trnila/homjachit/board/hamboard.kicad_pcb

## KiCad design board/hamboard.kicad_pcb (2022-09-10)

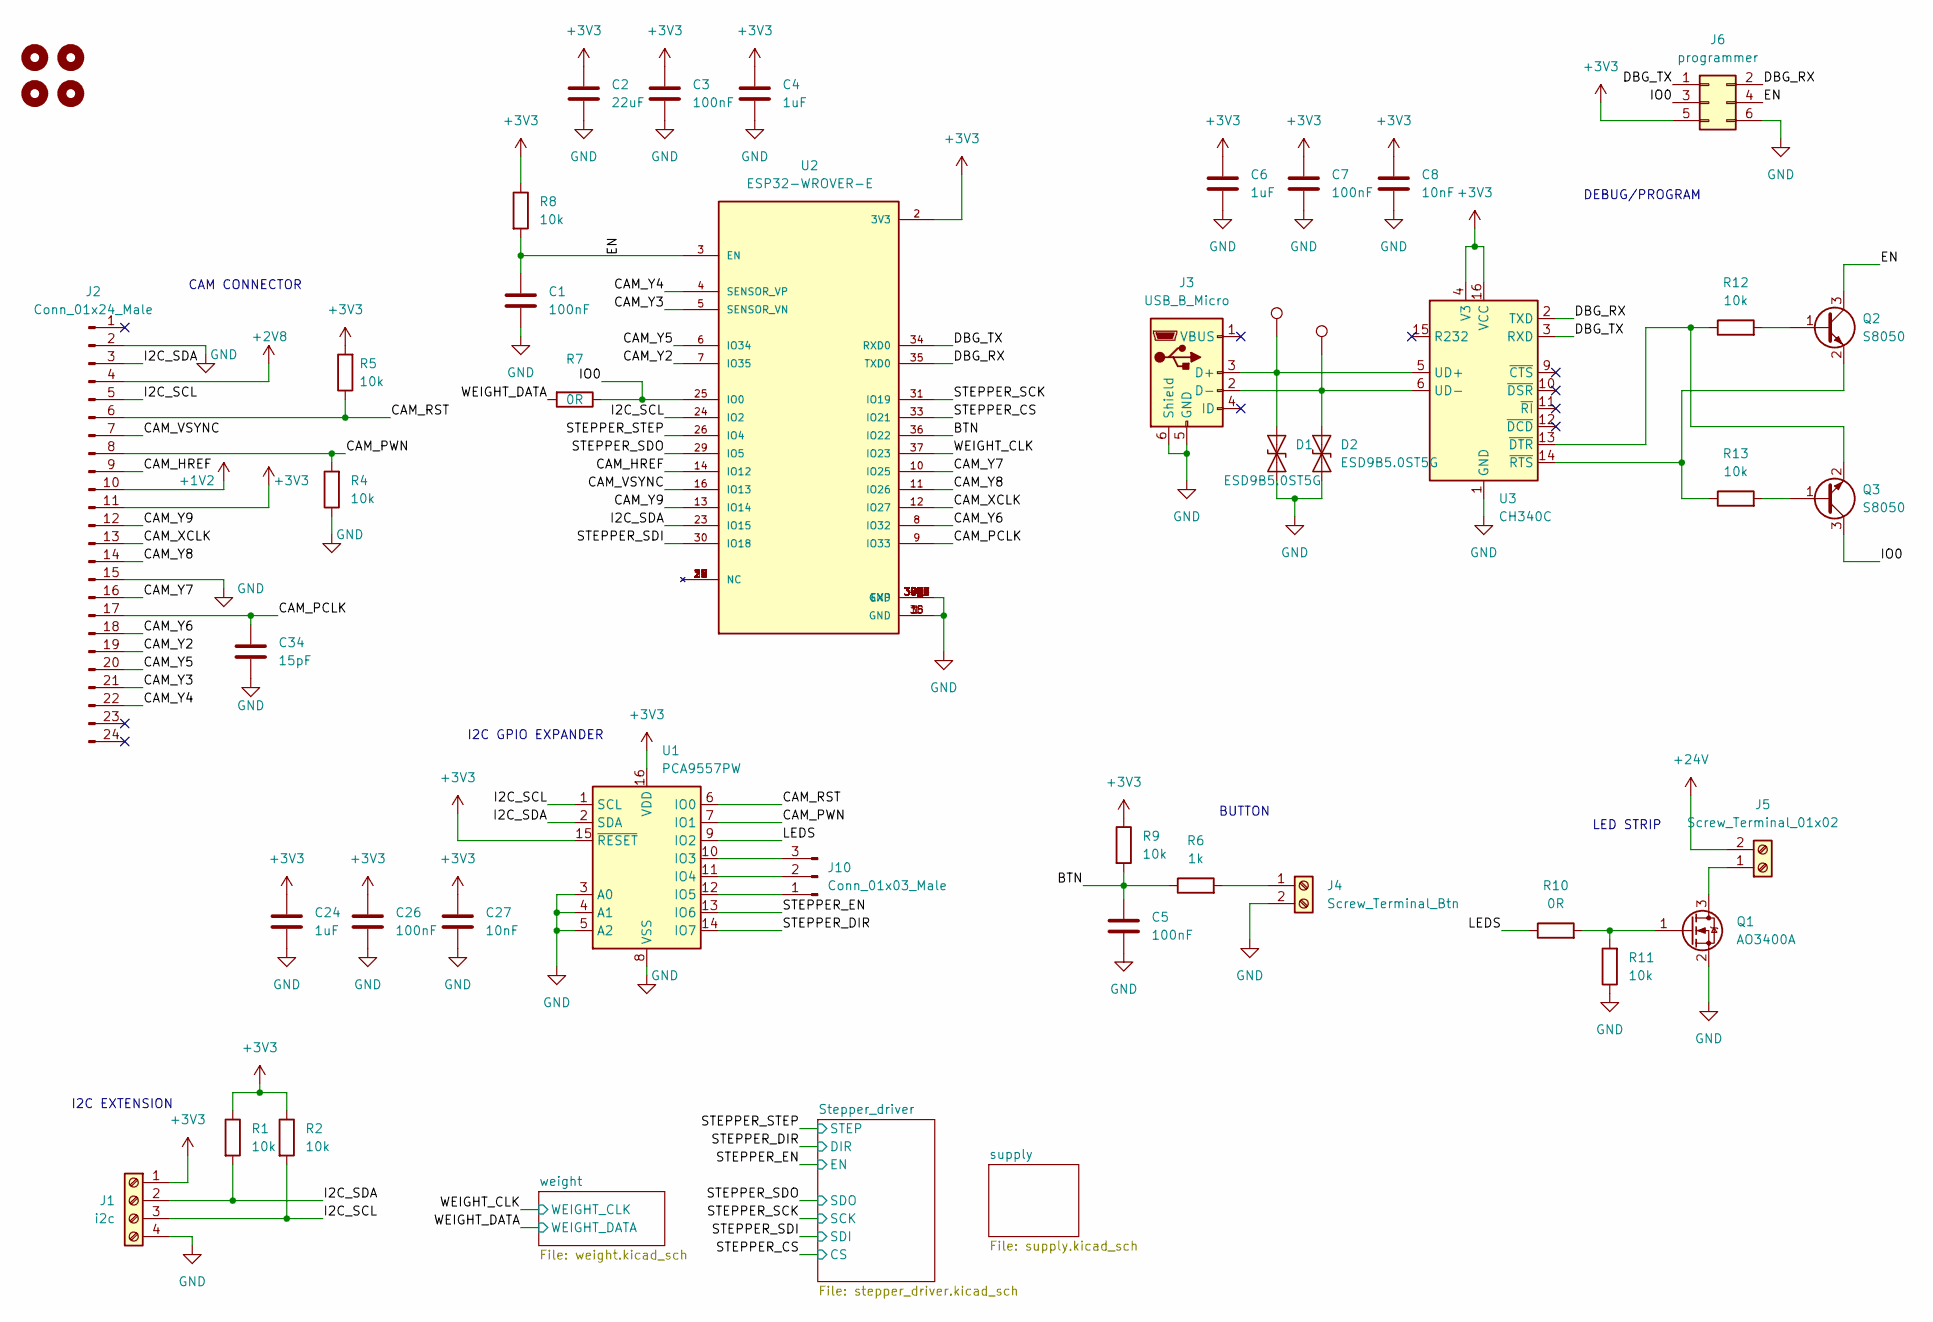
[picture p1: schematic hamboard.kicad_sch]

Parts:
C1, C3, C5, C7, C26: 100nF; C_0805_2012Metric; LCSC C282732
C2: 22uF; CP_EIA-1608-10_AVX-L; LCSC C29277
C4, C6, C24: 1uF; C_0805_2012Metric; LCSC C2798196
C8, C27: 10nF; C_0805_2012Metric; LCSC C376921
C34: 15pF; C_0805_2012Metric; LCSC C63339
D1, D2: ESD9B5.0ST5G; D_SOD-923; LCSC C2985641
H1, H2, H3, H4: MountingHole; MountingHole_3.2mm_M3
J1: i2c; PinHeader_1x04_P2.54mm_Vertical; LCSC C557656
J2: Conn_01x24_Male; Hirose_FH12-24S-0.5SH_1x24-1MP_P0.50mm_Horizontal; LCSC C2858298
J3: USB_B_Micro; USB_Micro-B_GCT_USB3076-30-A; LCSC C132562
J4: Screw_Terminal_Btn; TerminalBlock_bornier-2_P5.08mm; LCSC C394556
J5: Screw_Terminal_01x02; TerminalBlock_bornier-2_P5.08mm; LCSC C394556
J6: programmer; PinHeader_2x03_P2.54mm_Vertical
J10: Conn_01x03_Male; PinHeader_1x03_P2.54mm_Vertical
Q1: AO3400A; SOT-23; LCSC C347475
Q2, Q3: S8050; SOT-23; LCSC C2891804
R1, R2, R4, R5, R8, R9, R11, R12, R13: 10k; R_0805_2012Metric; LCSC C2930231
R6: 1k; R_0805_2012Metric; LCSC C2907295
R7: 0R; R_0805_2012Metric; LCSC C2930231
R10: 0R; R_0805_2012Metric; LCSC C2907288
TP10, TP11: TestPoint; TestPoint_Pad_D1.5mm
U1: PCA9557PW; TSSOP-16_4.4x5mm_P0.65mm; LCSC C141380
U2: ESP32-WROVER-E; XCVR_ESP32-WROVER-E-N4R8; PARTREV 1.6; LCSC C529589
U3: CH340C; SOIC-16_3.9x9.9mm_P1.27mm; LCSC C84681

Connections:
+1V2: J2.10; also elsewhere on the board
+2V8: J2.4; also elsewhere on the board
+3V3: C2.1, C3.1, C4.1, C6.1, C7.1, C8.1, C24.1, C26.1, C27.1, J1.1, J2.11, J6.5, R1.1, R2.1, R5.2, R8.1, R9.1, U1.15 (~RESET), U1.16 (VDD), U2.2 (3V3), U3.4 (V3), U3.16 (VCC); also elsewhere on the board
+24V: J5.2; also elsewhere on the board
/BTN: C5.1, R6.1, R9.2, U2.36 (IO22)
/CAM_HREF: J2.9, U2.14 (IO12)
/CAM_PCLK: C34.1, J2.17, U2.9 (IO33)
/CAM_PWN: J2.8, R4.2, U1.7 (IO1)
/CAM_RST: J2.6, R5.1, U1.6 (IO0)
/CAM_VSYNC: J2.7, U2.16 (IO13)
/CAM_XCLK: J2.13, U2.12 (IO27)
/CAM_Y2: J2.19, U2.7 (IO35)
/CAM_Y3: J2.21, U2.5 (SENSOR_VN)
/CAM_Y4: J2.22, U2.4 (SENSOR_VP)
/CAM_Y5: J2.20, U2.6 (IO34)
/CAM_Y6: J2.18, U2.8 (IO32)
/CAM_Y7: J2.16, U2.10 (IO25)
/CAM_Y8: J2.14, U2.11 (IO26)
/CAM_Y9: J2.12, U2.13 (IO14)
/DBG_RX: J6.2, U2.35 (TXD0), U3.2 (TXD)
/DBG_TX: J6.1, U2.34 (RXD0), U3.3 (RXD)
/EN: C1.1, J6.4, Q2.3 (C), R8.2, U2.3 (EN)
/I2C_SCL: J1.3, J2.5, R2.2, U1.1 (SCL), U2.24 (IO2)
/I2C_SDA: J1.2, J2.3, R1.2, U1.2 (SDA), U2.23 (IO15)
/IO0: J6.3, Q3.3 (C), R7.1, U2.25 (IO0)
/LEDS: R10.1, U1.9 (IO2)
/STEPPER_CS: U2.33 (IO21); also elsewhere on the board
/STEPPER_DIR: U1.14 (IO7); also elsewhere on the board
/STEPPER_EN: U1.13 (IO6); also elsewhere on the board
/STEPPER_SCK: U2.31 (IO19); also elsewhere on the board
/STEPPER_SDI: U2.30 (IO18); also elsewhere on the board
/STEPPER_SDO: U2.29 (IO5); also elsewhere on the board
/STEPPER_STEP: U2.26 (IO4); also elsewhere on the board
/WEIGHT_CLK: U2.37 (IO23); also elsewhere on the board
/WEIGHT_DATA: R7.2; also elsewhere on the board
GND: C1.2, C2.2, C3.2, C4.2, C5.2, C6.2, C7.2, C8.2, C24.2, C26.2, C27.2, C34.2, D1.1 (A1), D2.1 (A1), J1.4, J2.2, J2.15, J3.5 (GND), J3.6 (Shield), J4.2, J6.6, Q1.2 (S), R4.1, R11.1, U1.3 (A0), U1.4 (A1), U1.5 (A2), U1.8 (VSS), U2.1 (GND), U2.15 (GND), U2.38 (GND), U2.39_1 (EXP), U2.39_2 (EXP), U2.39_3 (EXP), U2.39_4 (EXP), U2.39_5 (EXP), U2.39_6 (EXP), U2.39_7 (EXP), U2.39_8 (EXP), U2.39_9 (EXP), U2.40 (GND), U2.41 (GND), U2.42 (GND), U2.43 (GND), U2.44 (GND), U2.45 (GND), U2.46 (GND), U2.47 (GND), U2.48 (GND), U2.49 (GND), U2.50 (GND), U2.51 (GND), U3.1 (GND); also elsewhere on the board
unnamed: D1.2 (A2), J3.3 (D+), TP10.1, U3.5 (UD+)
unnamed: D2.2 (A2), J3.2 (D-), TP11.1, U3.6 (UD-)
unnamed: J4.1, R6.2
unnamed: J5.1, Q1.3 (D)
unnamed: J10.1, U1.12 (IO5)
unnamed: J10.2, U1.11 (IO4)
unnamed: J10.3, U1.10 (IO3)
unnamed: Q1.1 (G), R10.2, R11.2
unnamed: Q2.1 (B), R12.2
unnamed: Q2.2 (E), R13.1, U3.14 (~RTS)
unnamed: Q3.1 (B), R13.2
unnamed: Q3.2 (E), R12.1, U3.13 (~DTR)

Notes on the sheet:
I2C GPIO EXPANDER
CAM CONNECTOR
DEBUG/PROGRAM
BUTTON
I2C EXTENSION
LED STRIP

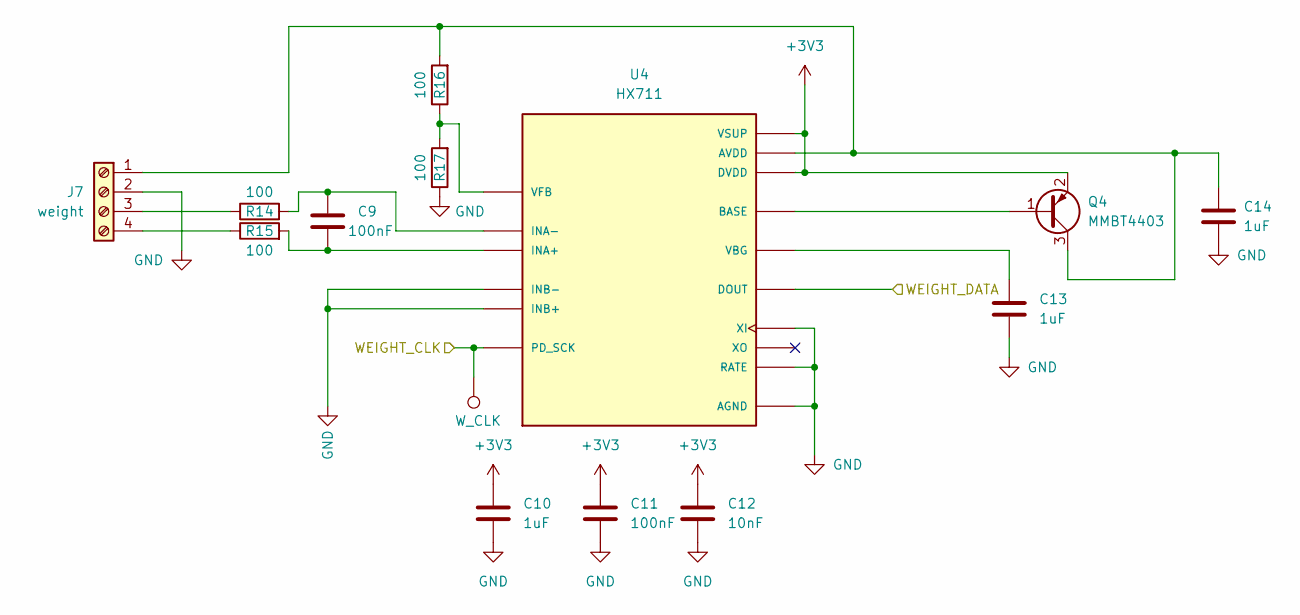
[picture p2: schematic weight.kicad_sch]

Parts:
C9, C11: 100nF; C_0805_2012Metric
C10, C13, C14: 1uF; C_0805_2012Metric
C12: 10nF; C_0805_2012Metric
J7: weight; TerminalBlock_bornier-4_P5.08mm; LCSC C557656
Q4: MMBT4403; SOT-23; LCSC C181124
R14, R15, R16, R17: 100; R_0805_2012Metric
TP4: W_CLK; TestPoint_Pad_D1.5mm
U4: HX711; SOP127P600X180-16N; PARTREV V2.0; LCSC C43656

Connections:
+3V3: C10.1, C11.1, C12.1, Q4.2 (E), U4.1 (VSUP), U4.16 (DVDD); also elsewhere on the board
/WEIGHT_CLK: TP4.1, U4.11 (PD_SCK); also elsewhere on the board
/WEIGHT_DATA: U4.12 (DOUT); also elsewhere on the board
GND: C10.2, C11.2, C12.2, C13.2, C14.2, J7.2, R17.1, U4.5 (AGND), U4.9 (INB-), U4.10 (INB+), U4.14 (XI), U4.15 (RATE); also elsewhere on the board
unnamed: C9.1, R14.2, U4.7 (INA-)
unnamed: C9.2, R15.2, U4.8 (INA+)
unnamed: C13.1, U4.6 (VBG)
unnamed: C14.1, J7.1, Q4.3 (C), R16.2, U4.3 (AVDD)
unnamed: J7.3, R14.1
unnamed: J7.4, R15.1
unnamed: Q4.1 (B), U4.2 (BASE)
unnamed: R16.1, R17.2, U4.4 (VFB)

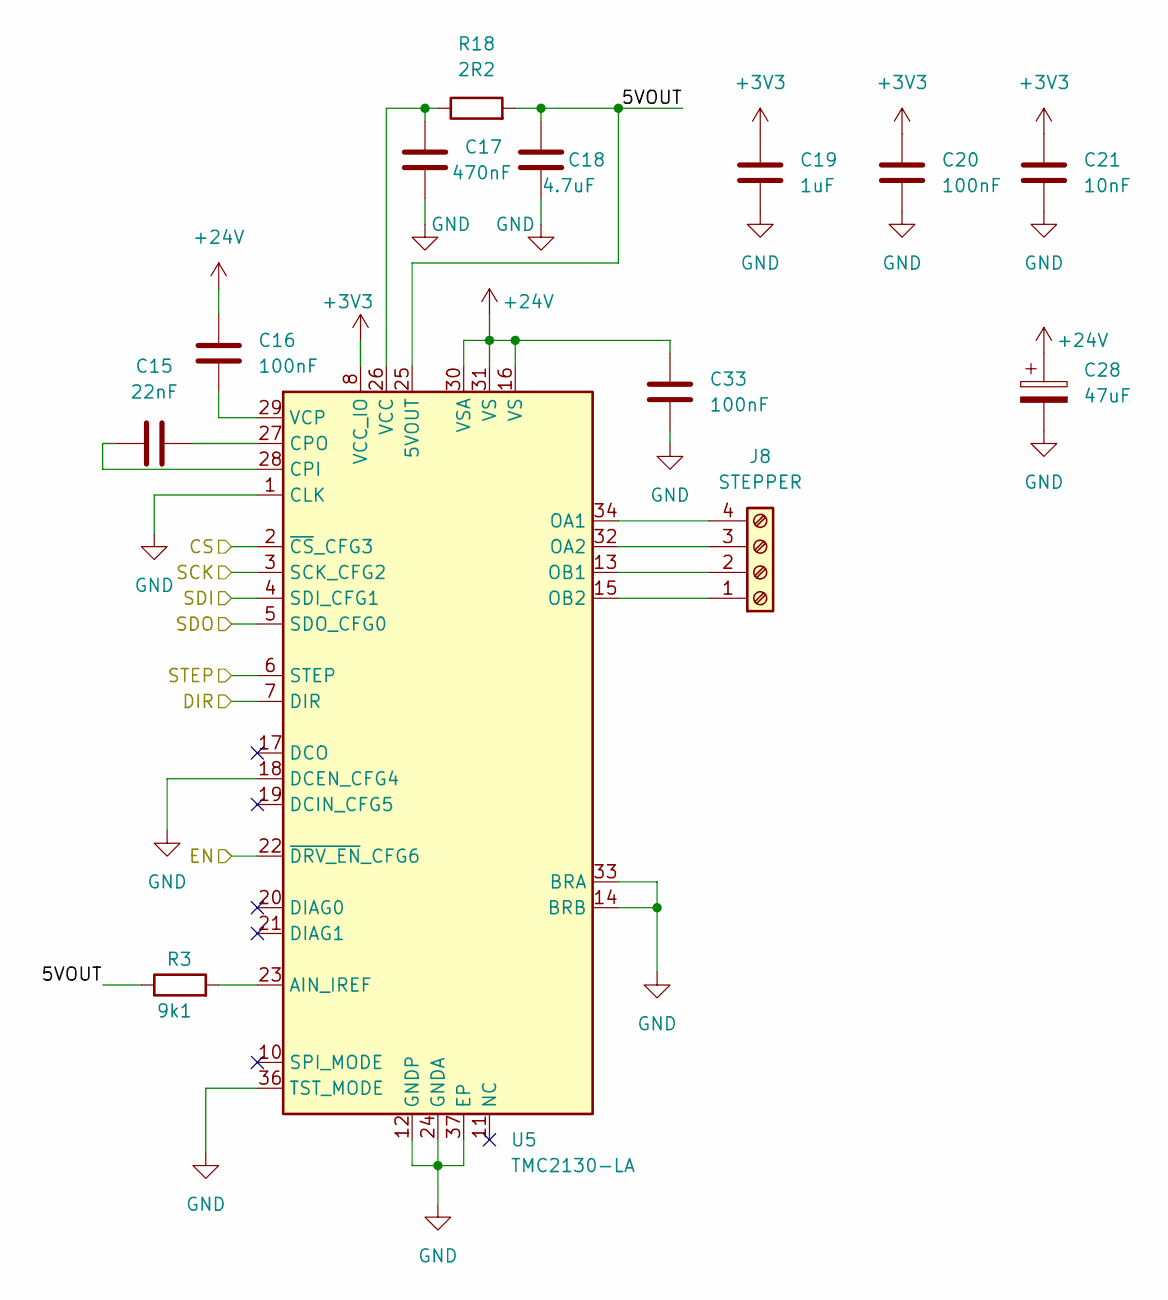
[picture p3: schematic stepper_driver.kicad_sch]

Parts:
C15: 22nF; C_0805_2012Metric
C16, C20, C33: 100nF; C_0805_2012Metric
C17: 470nF; C_0805_2012Metric
C18: 4.7uF; C_0805_2012Metric
C19: 1uF; C_0805_2012Metric
C21: 10nF; C_0805_2012Metric
C28: 47uF; CP_Elec_6.3x7.7; LCSC C88677
J8: STEPPER; TerminalBlock_bornier-4_P5.08mm; LCSC C557656
R3: 9k1; R_0805_2012Metric
R18: 2R2; R_0805_2012Metric
U5: TMC2130-LA; QFN-36-1EP_5x6mm_P0.5mm_EP3.6x4.1mm; LCSC C915795

Connections:
+3V3: C19.1, C20.1, C21.1, U5.8 (VCC_IO); also elsewhere on the board
+24V: C16.2, C28.1, C33.1, U5.16 (VS), U5.30 (VSA), U5.31 (VS); also elsewhere on the board
/STEPPER_CS: U5.2 (~CS_CFG3); also elsewhere on the board
/STEPPER_DIR: U5.7 (DIR); also elsewhere on the board
/STEPPER_EN: U5.22 (~DRV_EN_CFG6); also elsewhere on the board
/STEPPER_SCK: U5.3 (SCK_CFG2); also elsewhere on the board
/STEPPER_SDI: U5.4 (SDI_CFG1); also elsewhere on the board
/STEPPER_SDO: U5.5 (SDO_CFG0); also elsewhere on the board
/STEPPER_STEP: U5.6 (STEP); also elsewhere on the board
/Stepper_driver/5VOUT: C18.1, R3.1, R18.2, U5.25 (5VOUT)
GND: C17.2, C18.2, C19.2, C20.2, C21.2, C28.2, C33.2, U5.1 (CLK), U5.12 (GNDP), U5.14 (BRB), U5.18 (DCEN_CFG4), U5.24 (GNDA), U5.33 (BRA), U5.35 (GNDP), U5.36 (TST_MODE), U5.37 (EP); also elsewhere on the board
unnamed: C15.1, U5.28 (CPI)
unnamed: C15.2, U5.27 (CPO)
unnamed: C16.1, U5.29 (VCP)
unnamed: C17.1, R18.1, U5.26 (VCC)
unnamed: J8.1, U5.15 (OB2)
unnamed: J8.2, U5.13 (OB1)
unnamed: J8.3, U5.32 (OA2)
unnamed: J8.4, U5.34 (OA1)
unnamed: R3.2, U5.23 (AIN_IREF)

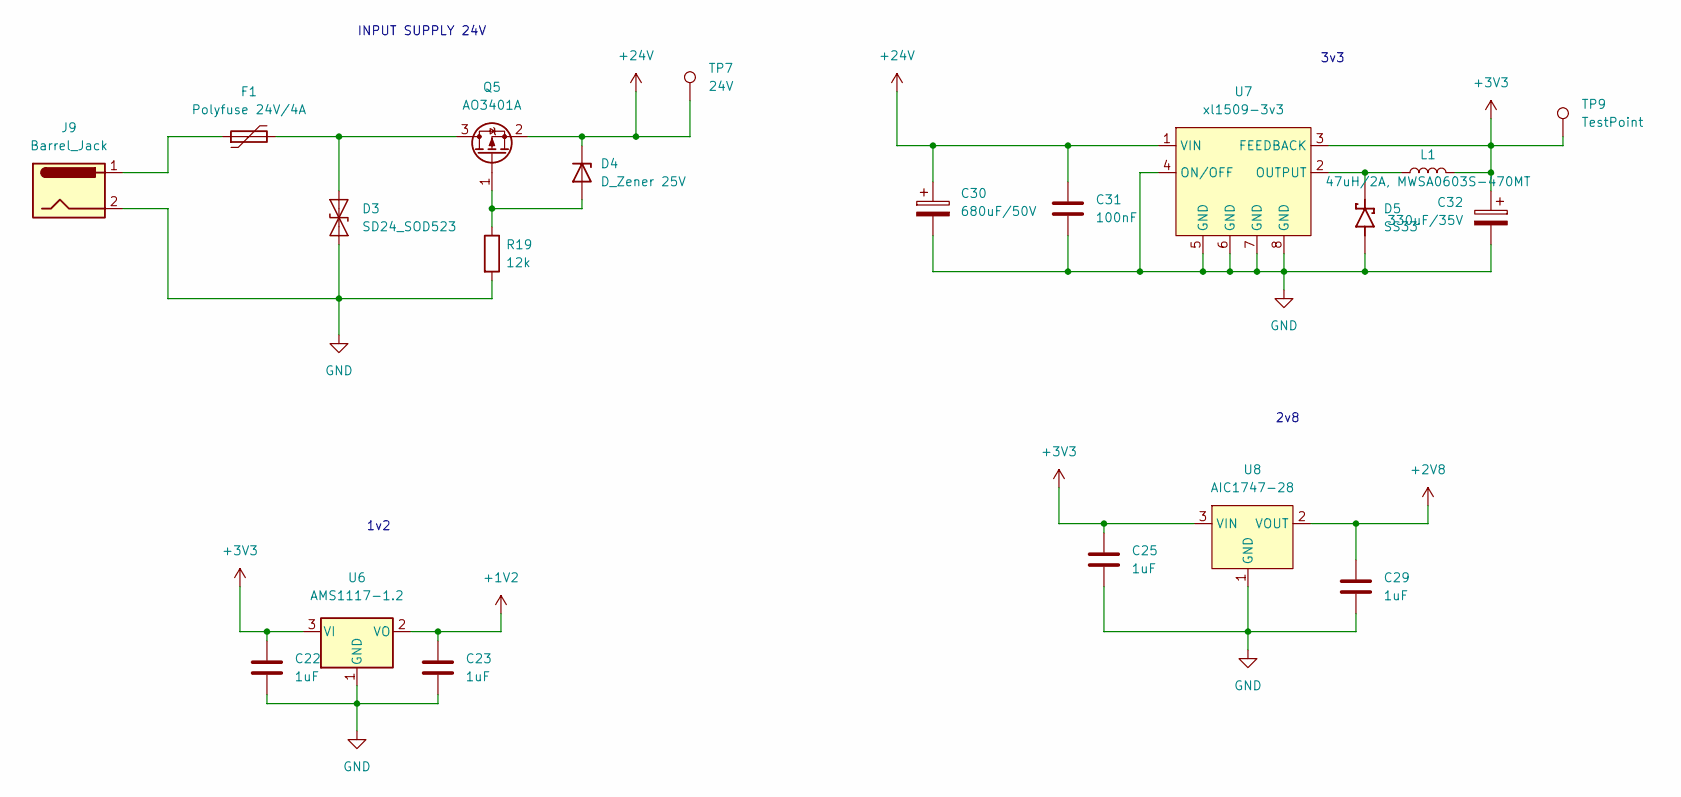
[picture p4: schematic supply.kicad_sch]

Parts:
C22, C23, C25, C29: 1uF; C_0805_2012Metric
C30: 680uF/50V; CP_Radial_D13.0mm_P5.00mm; LCSC C399014
C31: 100nF; C_0805_2012Metric
C32: 330uF/35V; CP_Elec_10x10.5; LCSC C310832
D3: SD24_SOD523; D_SOD-323; LCSC C558432
D4: D_Zener 25V; D_MiniMELF; LCSC C118705
D5: SS33; DIOM6859X262N; PARTREV Q2102; LCSC C64998
F1: Polyfuse 24V/4A; Fuse_2920_7451Metric; LCSC C2982292
J9: Barrel_Jack; BarrelJack_CLIFF_FC681465S_SMT_Horizontal; LCSC C381116
L1: 47uH/2A, MWSA0603S-470MT; L_7.3x7.3_H3.5; LCSC C408455
Q5: AO3401A; SOT-23; LCSC C700954
R19: 12k; R_0805_2012Metric
TP7: 24V; TestPoint_Pad_D1.5mm
TP9: TestPoint; TestPoint_Pad_D1.5mm
U6: AMS1117-1.2; SOT-223-3_TabPin2; LCSC C2992568
U7: xl1509-3v3; SOIC-8_3.9x4.9mm_P1.27mm; LCSC C2681226
U8: AIC1747-28; TSOT-23_HandSoldering; LCSC C238238

Connections:
+1V2: C23.1, U6.2 (VO); also elsewhere on the board
+2V8: C29.1, U8.2 (VOUT); also elsewhere on the board
+3V3: C22.1, C25.1, C32.1, L1.2, TP9.1, U6.3 (VI), U7.3 (FEEDBACK), U8.3 (VIN); also elsewhere on the board
+24V: C30.1, C31.1, D4.1 (K), Q5.2 (S), TP7.1, U7.1 (VIN); also elsewhere on the board
GND: C22.2, C23.2, C25.2, C29.2, C30.2, C31.2, C32.2, D3.1 (A1), D5.A, J9.2, R19.2, U6.1 (GND), U7.4 (ON/OFF), U7.5 (GND), U7.6 (GND), U7.7 (GND), U7.8 (GND), U8.1 (GND); also elsewhere on the board
unnamed: D3.2 (A2), F1.2, Q5.3 (D)
unnamed: D4.2 (A), Q5.1 (G), R19.1
unnamed: D5.C, L1.1, U7.2 (OUTPUT)
unnamed: F1.1, J9.1

Notes on the sheet:
1v2
2v8
3v3
INPUT SUPPLY 24V

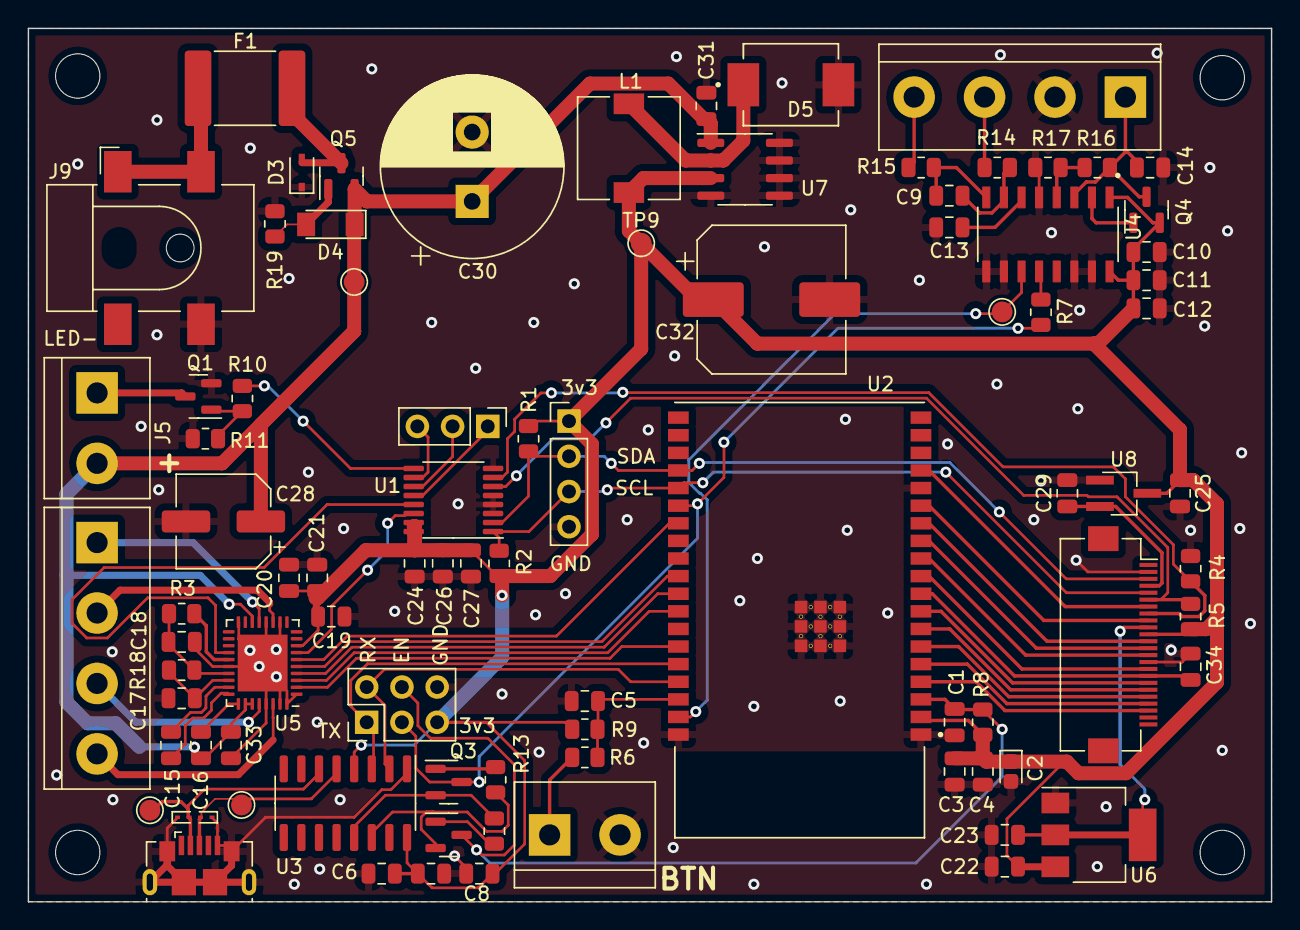
[picture p5: board hamboard.kicad_pcb from above]

Board: 2 copper layers, 89.7 x 63.0 mm, 92 parts (0 on the bottom side), 70 nets.
