trnila/homjachit/firmware/main/main.c

#include <esp_log.h>
#include <nvs_flash.h>
#include "esp_wifi.h"
#include "esp_http_server.h"
#include "camera.h"
#include "stream.h"

esp_err_t httpd_get_index(httpd_req_t *req){
  httpd_resp_sendstr(req, "<h1>oVerEnginEEred automatic feeder</h1><img id='camera'><img id='camera'><script>document.getElementById('camera').src = `http://${document.location.host}:81/`;</script>");
  return ESP_OK;
}

httpd_uri_t uri_get = {
  .uri      = "/",
  .method   = HTTP_GET,
  .handler  = httpd_get_index,
  .user_ctx = NULL
};

static char stats[1024];

void app_main() {
  nvs_flash_init();

  ESP_ERROR_CHECK(esp_netif_init());
  ESP_ERROR_CHECK(esp_event_loop_create_default());
  esp_netif_create_default_wifi_sta();

  wifi_init_config_t cfg = WIFI_INIT_CONFIG_DEFAULT();
  ESP_ERROR_CHECK(esp_wifi_init(&cfg));

  wifi_config_t wifi_config = {
    .sta = {
      .ssid = "user",
      .password = "pass",
    },
  };
  ESP_ERROR_CHECK(esp_wifi_set_mode(WIFI_MODE_STA));
  ESP_ERROR_CHECK(esp_wifi_set_config(WIFI_IF_STA, &wifi_config));
  ESP_ERROR_CHECK(esp_wifi_start());
  ESP_ERROR_CHECK(esp_wifi_connect());

  ESP_ERROR_CHECK(camera_start());
  ESP_ERROR_CHECK(stream_start());

  httpd_config_t config = HTTPD_DEFAULT_CONFIG();
  httpd_handle_t server = NULL;
  if (httpd_start(&server, &config) == ESP_OK) {
    httpd_register_uri_handler(server, &uri_get);
  }

  for(;;) {
    vTaskGetRunTimeStats(stats);
    printf("%s\n", stats);
    vTaskDelay(1000);
  }
}
