trnila/homjachit/(commit log)

2022-07-05 prevent slow client to slow everyone
    [hello_world_main.c]
2022-07-05 handle subscription by camera task
2022-08-24 initial board commit
    [cam.kicad_sch, hamboard.kicad_pcb, hamboard.kicad_sch, stepper_driver.kicad_sch, supply.kicad_sch, weight.kicad_sch]
2022-09-01 board: bom
    [hamboard.kicad_pcb, hamboard.kicad_sch, stepper_driver.kicad_sch, supply.kicad_sch, weight.kicad_sch]
2022-09-07 first pcb layout
    [hamboard.kicad_pcb, hamboard.kicad_sch, stepper_driver.kicad_sch, supply.kicad_sch, weight.kicad_sch]
2022-09-10 pcb: added screws and rerouted everything
    [hamboard.kicad_pcb, hamboard.kicad_sch, supply.kicad_sch]
2022-09-10 board: correct DRC issues
    [hamboard.kicad_pcb, hamboard.kicad_sch, stepper_driver.kicad_sch, supply.kicad_sch, weight.kicad_sch]
2022-09-10 board: fixed esp heat pads
    [hamboard.kicad_pcb, hamboard.kicad_sch, supply.kicad_sch, weight.kicad_sch]
2022-09-10 Removed duplicated footprints
    [hamboard.kicad_pcb, hamboard.kicad_sch, stepper_driver.kicad_sch, weight.kicad_sch]
2022-09-10 pcb: Centered
    [hamboard.kicad_pcb]
2022-09-10 board: renamed directory
    [cam.kicad_sch, hamboard.kicad_pcb, hamboard.kicad_sch, stepper_driver.kicad_sch, supply.kicad_sch, weight.kicad_sch]
